sbstjn/68Keys.io/README.md

# 68Keys.io

Build your own 68% mechanical keyboard with the DIY guide on [https://68keys.io](https://68keys.io)!

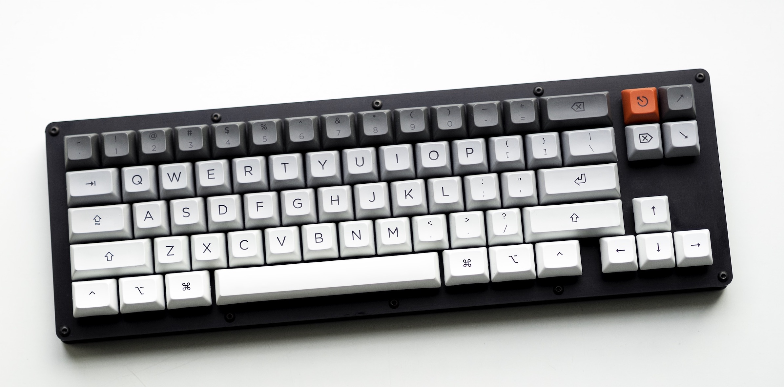
[picture p1: keyboard.jpg]
68Keys.io


> Photo by [Julia Kestner](http://julia-kestner.de/), [BY-NC-SA Creative Commons](https://github.com/sbstjn/68Keys.io/blob/master/LICENSE.md).
