sbstjn/68Keys.io/content/legal.md

---

title: Legal Information
description: Build your own 68% Mechanical Keyboard! Find all information about the Circuit Board, Aluminium Case, and QMK Firmware. A complete shopping list helps you with ordering all parts, and a detailed guide with photos supports you in building your own keyboard!
image: /images/og/splash.jpg

robots: NOINDEX, FOLLOW

---

### Publisher

*German legal information following section 5 TMG and person responsible for the content by 55 Abs. 2 RStV:*

Sebastian Müller\
Stresemannstraße 132\
22769 Hamburg\
Germany

### Contact

Mail: [bonjour@68keys.io](mailto:bonjour@68keys.io)\
Phone: [+49 151 54649055](tel:+4915154649055)

### Data Privacy

This is a static website hosted on [Netlify](https://www.netlify.com/), there is no collection of personal data.

Basic website analytics are done with [heft.io](https://heft.io).

### License

Everything is published using [BY-NC-SA Creative Commons][1], and source are available on [GitHub][7]. All Photos are contributed by [Julia Kestner][2] and shared with the same license.

Icons are from [Nucleo][8] and used with the [Nucleo Standard License][9].

For other external resources, the applying licenses are mentioned inline.

### Donations

If you enjoy this and want to show your love, [Dogecoins](http://dogecoin.com/) are much appreciated:

<code class="wallet">D8mKpbfGxHgadKdgoewkmXETN4JCgj92Xw</code>

### Disclaimer

The content of [68Keys.io][3] has been created with the utmost care. However, I cannot guarantee the contents' accuracy, completeness or topicality. According to statutory provisions, I am furthermore responsible for my content on these web pages. In this context, please note that I am accordingly not obliged to monitor merely the transmitted or saved information of third parties, or investigate circumstances pointing to illegal activity. My obligations to remove or block the use of information under generally applicable laws remain unaffected by this as per §§ 8 to 10 of the Telemedia Act (TMG).

Responsibility for the content of external links (to web pages of third parties) lies solely with the operators of the linked pages. No violations were evident to me at the time of linking. Should any legal infringement become known to me, I will remove the respective link immediately.

[1]: https://github.com/sbstjn/68Keys.io/blob/master/LICENSE.md
[2]: http://julia-kestner.de
[3]: https://68Keys.io
[7]: https://github.com/sbstjn/68keys.io
[8]: https://nucleoapp.com
[9]: https://nucleoapp.com/license
