sbstjn/68Keys.io/static/images/board/arduino-board.jpg

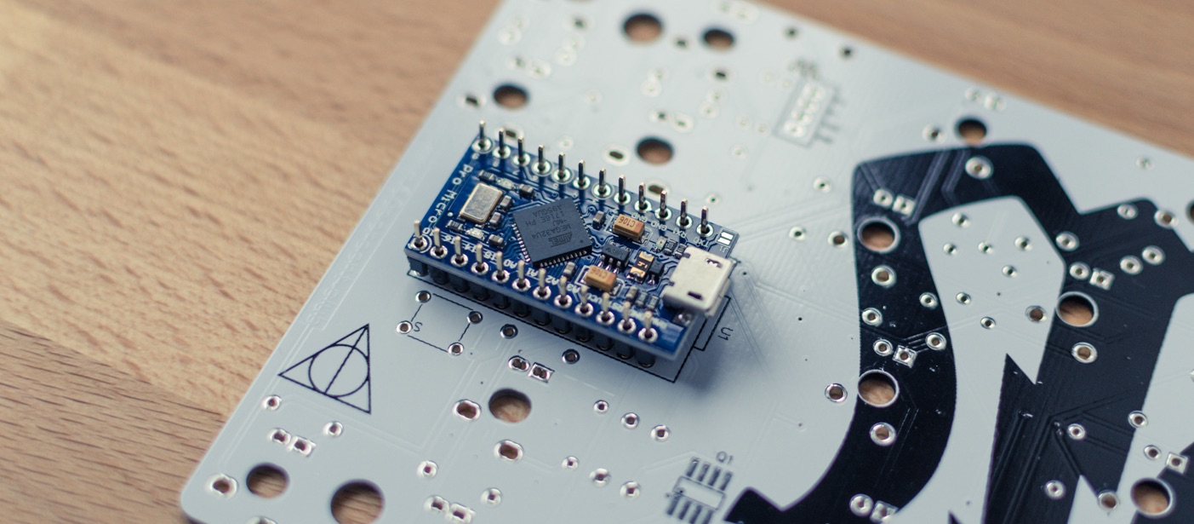
static/images/board/arduino-board.jpg
