sbstjn/68Keys.io/static/images/board/diodes-pre.jpg

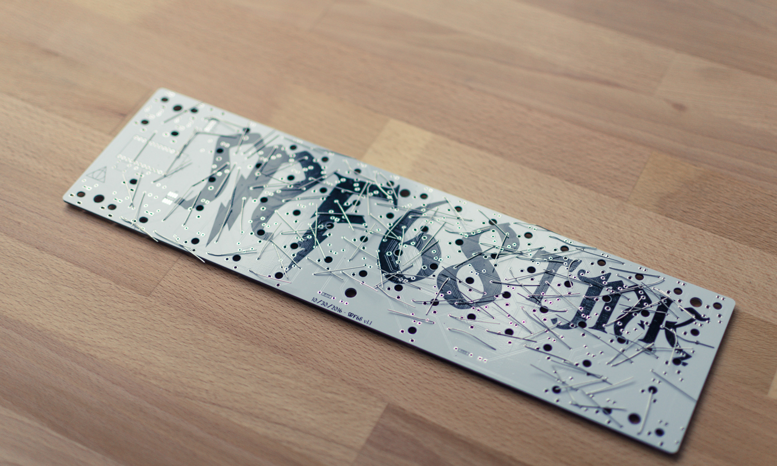
static/images/board/diodes-pre.jpg
