sbstjn/68Keys.io/static/images/board/diodes.jpg

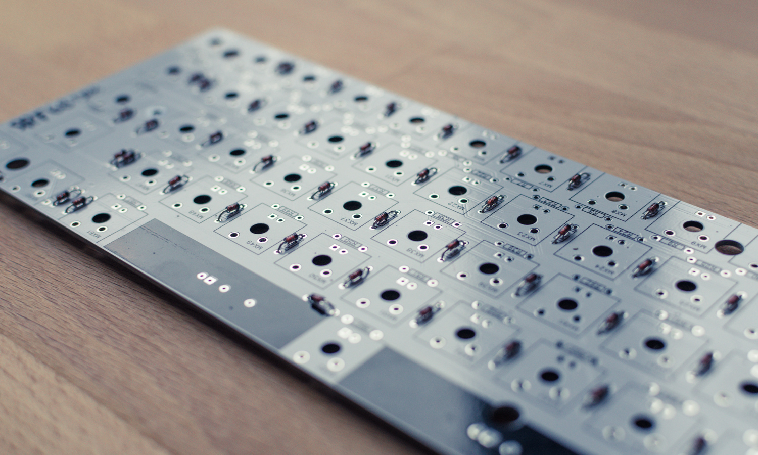
static/images/board/diodes.jpg
