sbstjn/68Keys.io/static/images/board/screenshot-easyeda.png

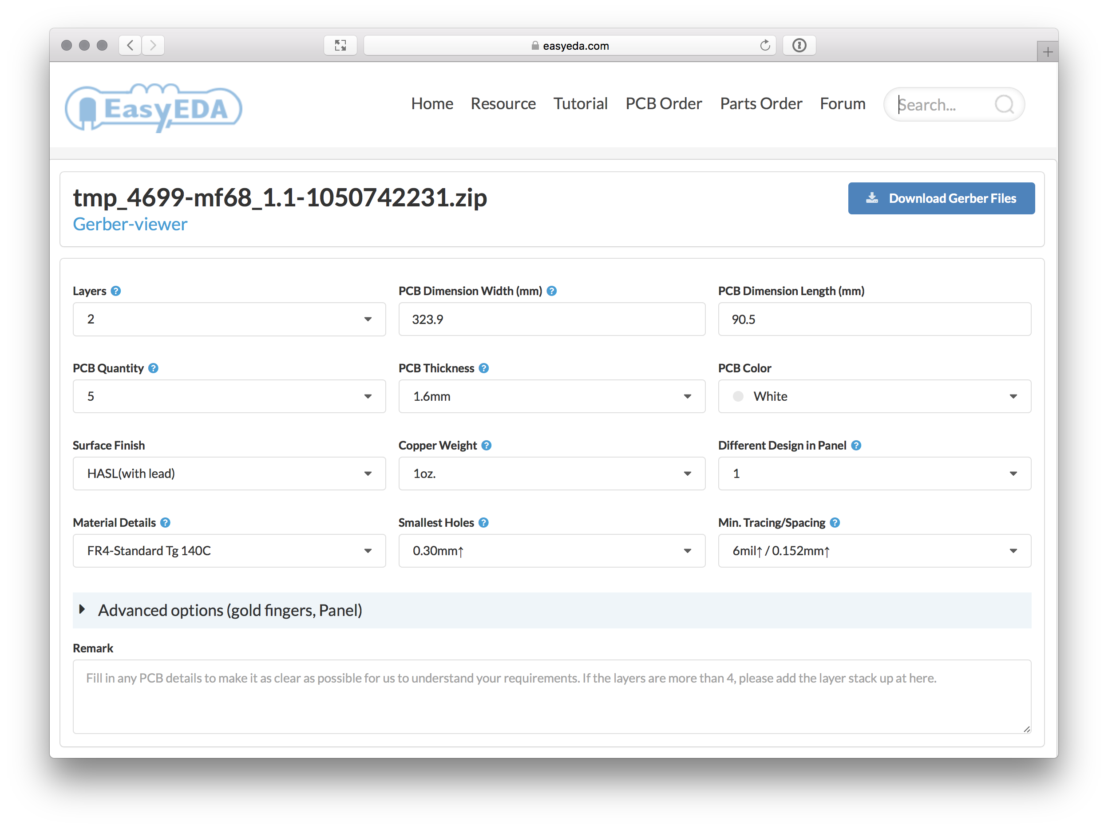
static/images/board/screenshot-easyeda.png
