sbstjn/68Keys.io/static/images/board/screenshot-preview.png

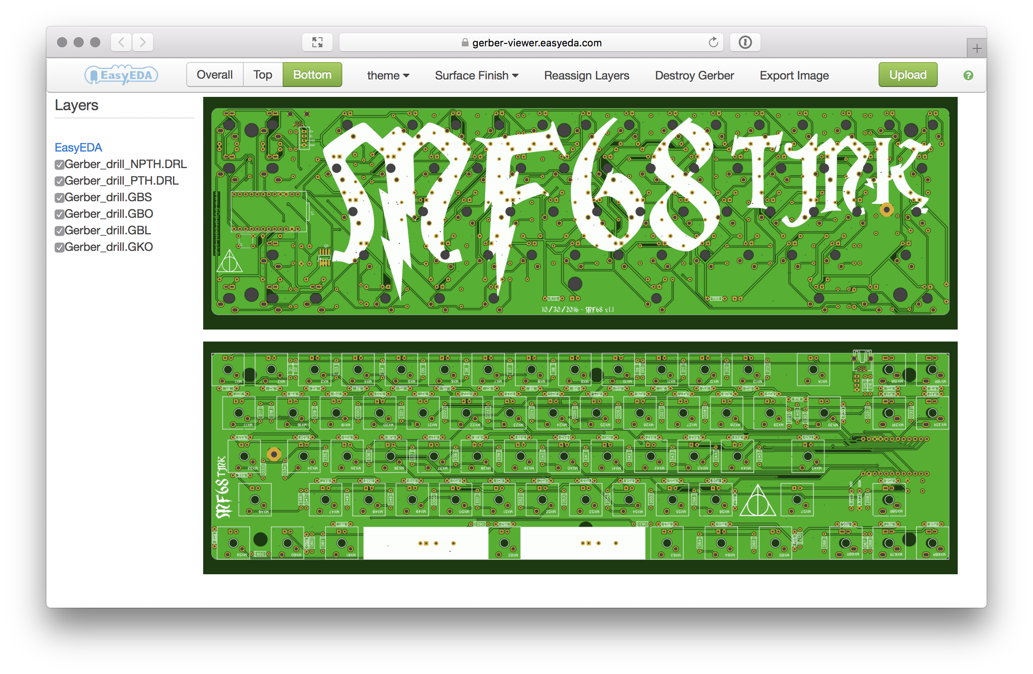
static/images/board/screenshot-preview.png
