sbstjn/68Keys.io/static/images/case/clean-both.jpg

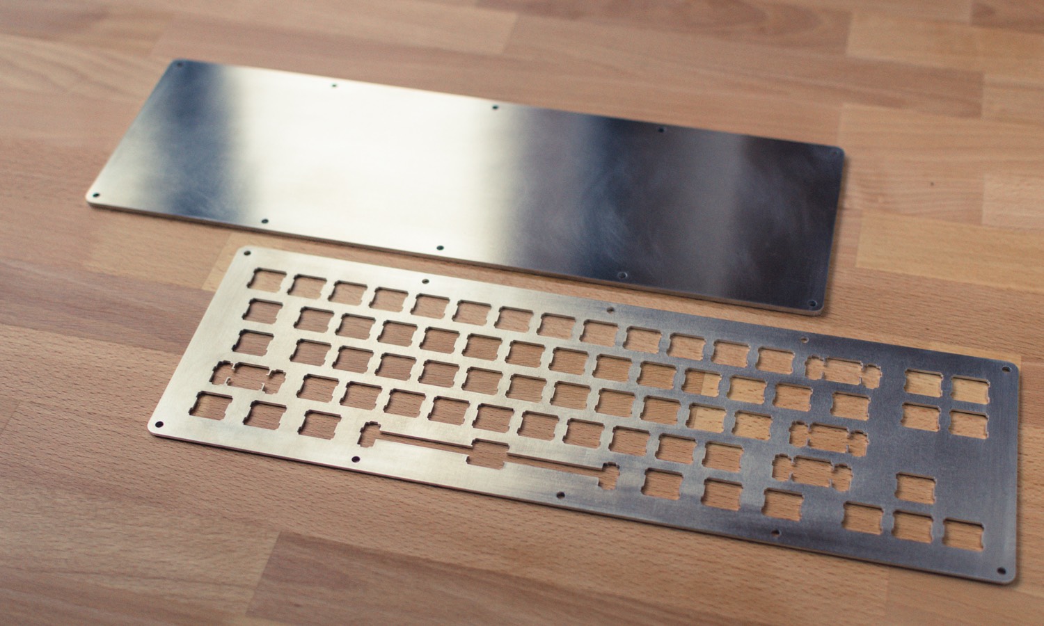
static/images/case/clean-both.jpg
