sbstjn/68Keys.io/static/images/case/clean-top.jpg

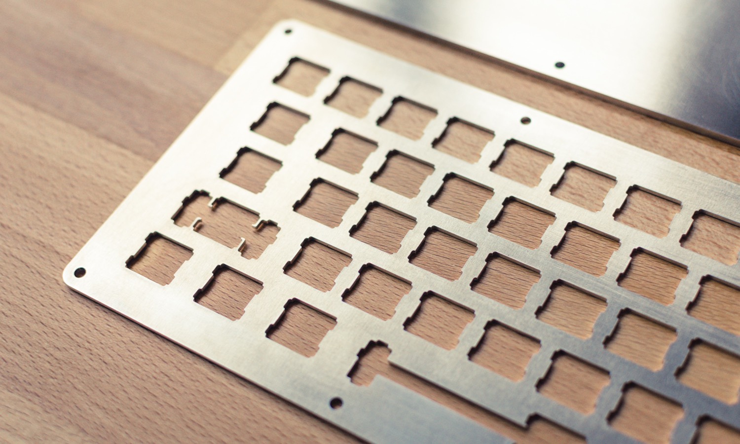
static/images/case/clean-top.jpg
