sbstjn/68Keys.io/static/images/case/plates-black.jpg

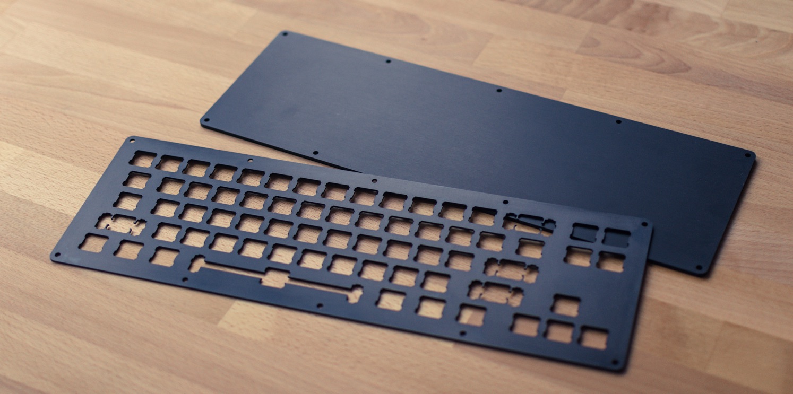
static/images/case/plates-black.jpg
