sbstjn/68Keys.io/static/images/case/raw-both.jpg

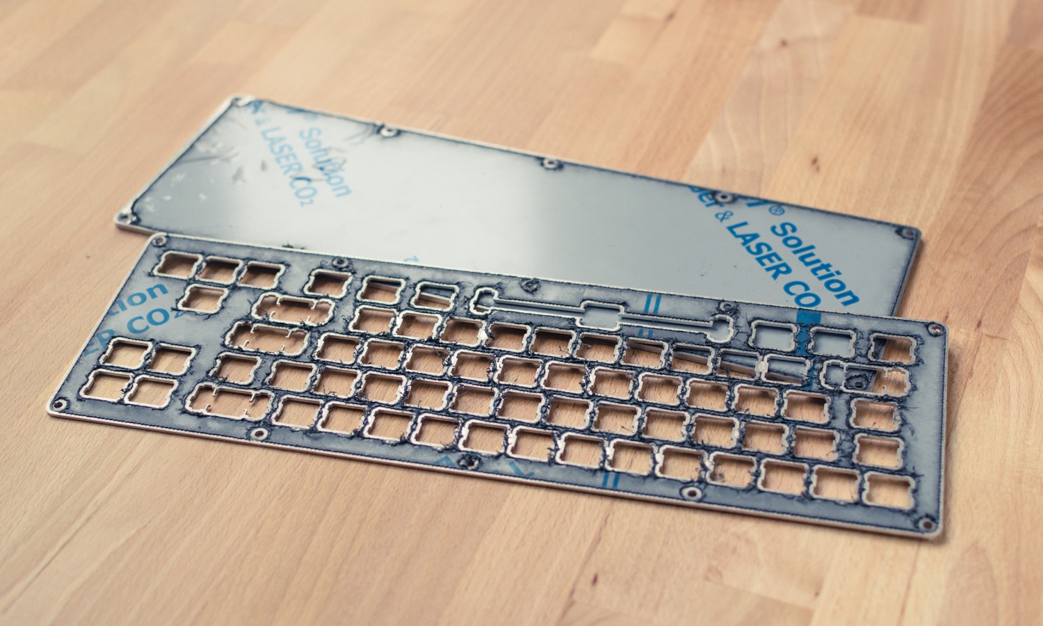
static/images/case/raw-both.jpg
