sbstjn/68Keys.io/static/images/case/raw-top.jpg

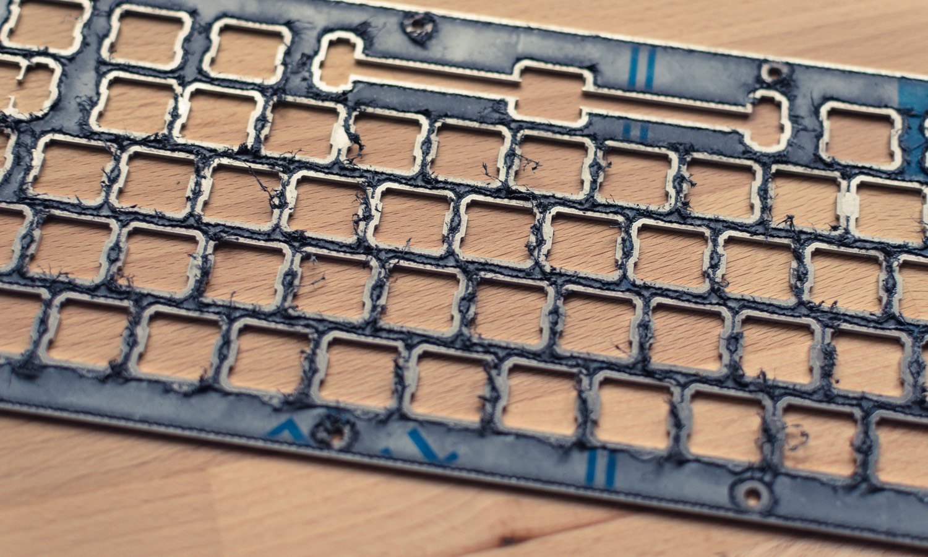
static/images/case/raw-top.jpg
