sbstjn/68Keys.io/static/images/case/screenshot-kle.png

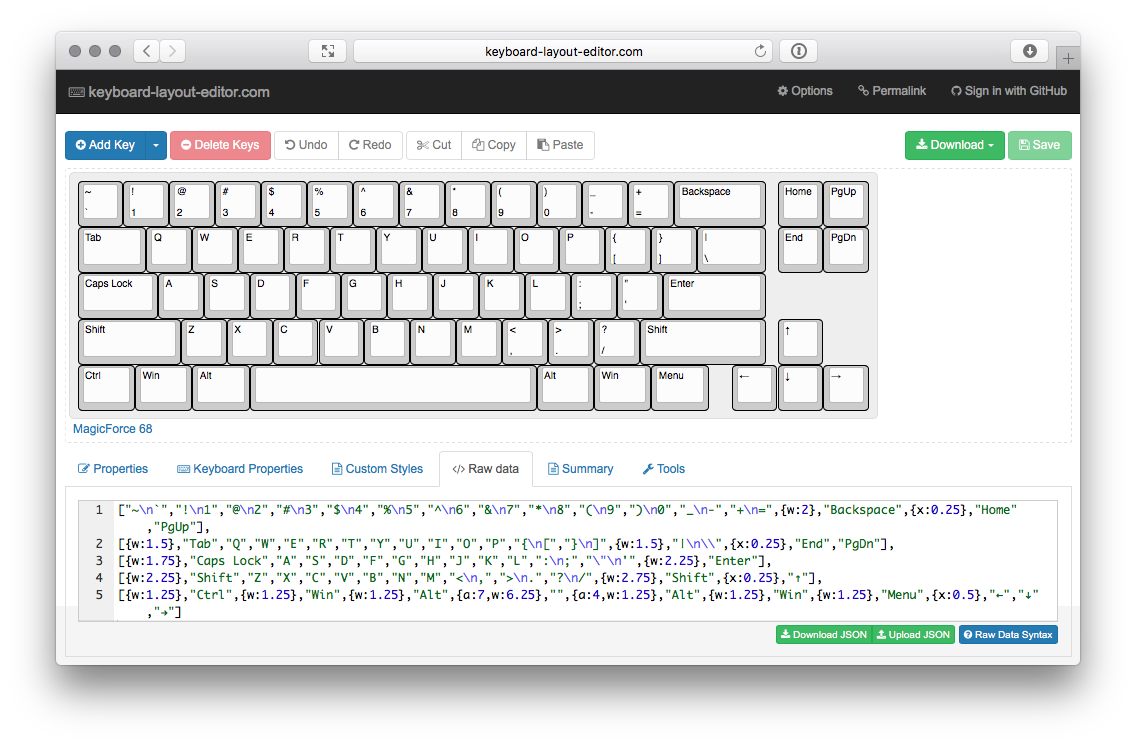
static/images/case/screenshot-kle.png
