sbstjn/68Keys.io/static/images/header.jpg

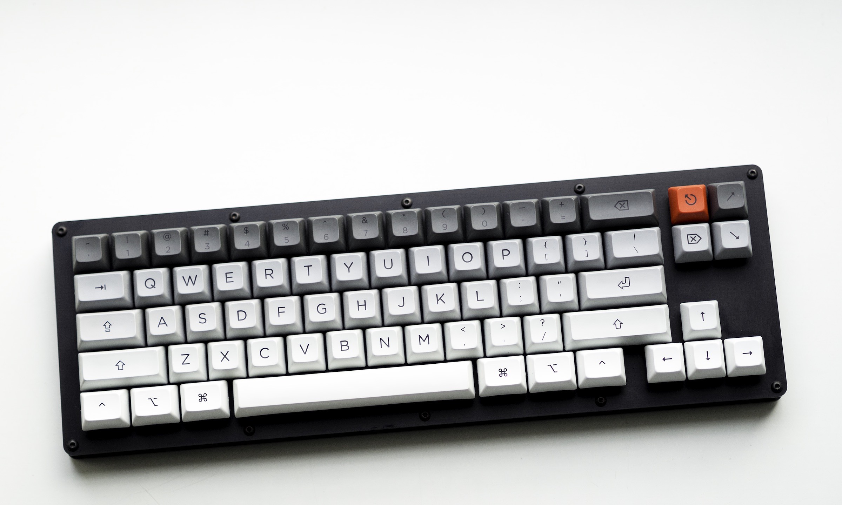
static/images/header.jpg
