sbstjn/68Keys.io/static/images/intro.jpg

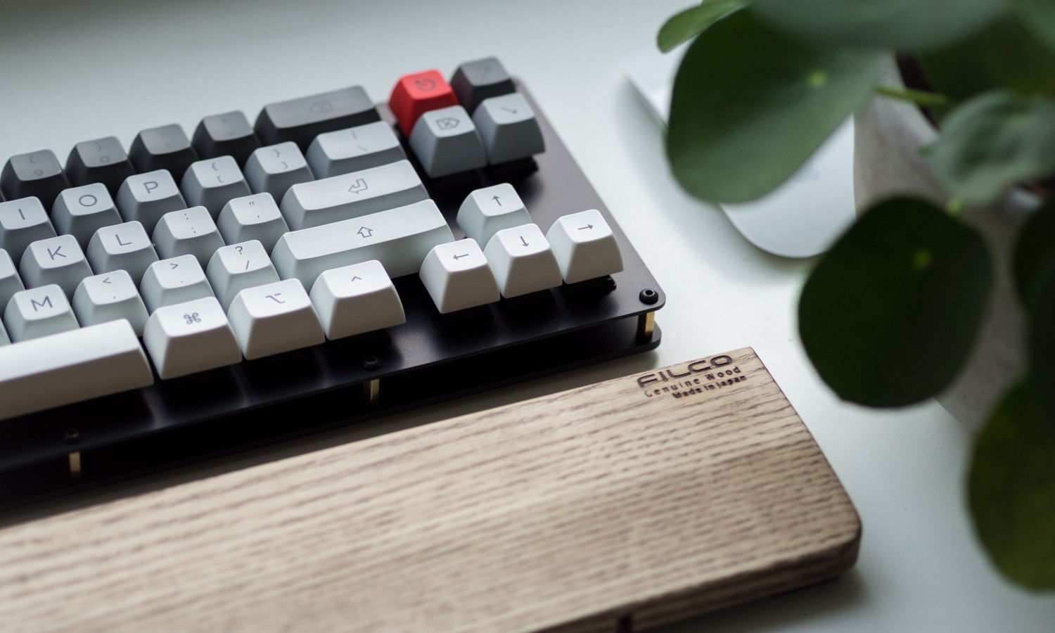
static/images/intro.jpg
