sbstjn/68Keys.io/static/images/board/parts.jpg

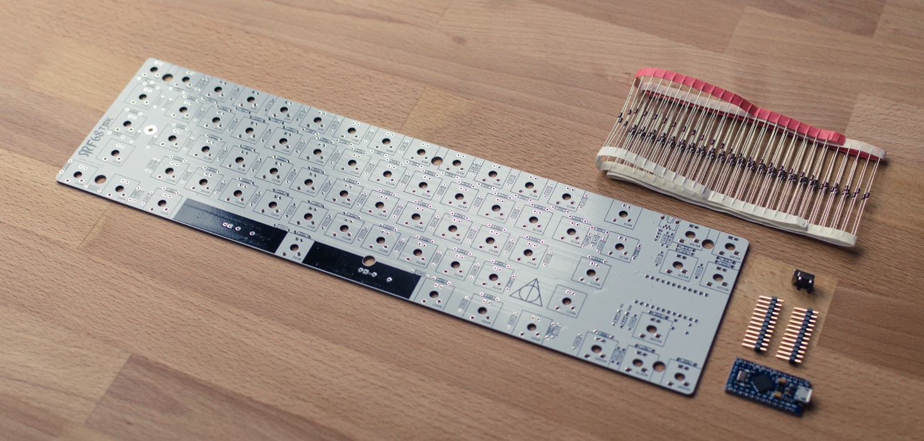
static/images/board/parts.jpg
