sbstjn/68Keys.io/static/images/case/parts-black-assembled.jpg

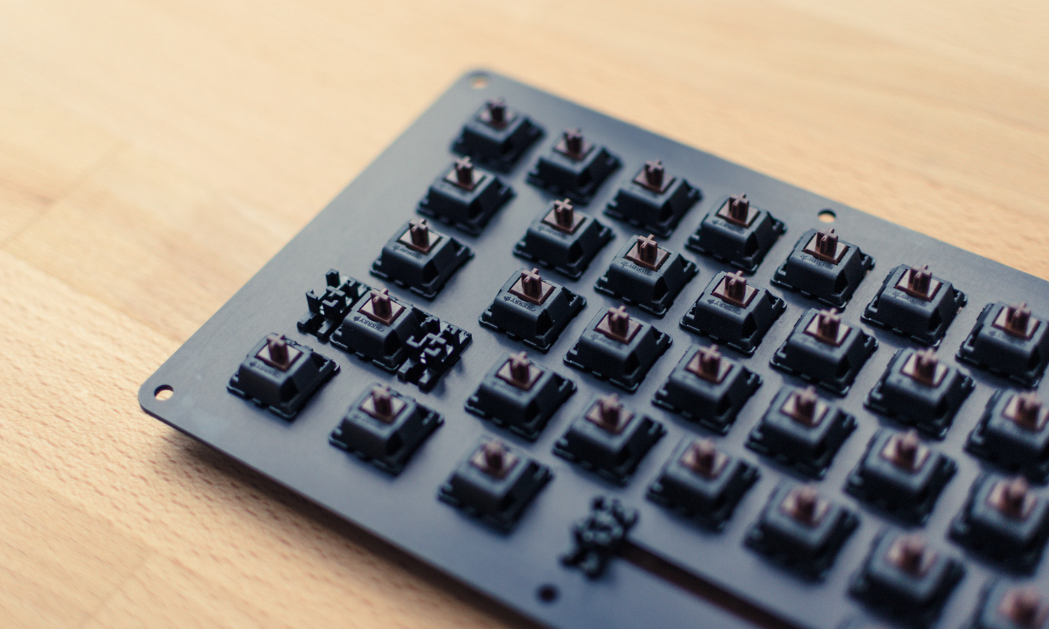
static/images/case/parts-black-assembled.jpg
