sbstjn/68Keys.io/static/images/case/parts-black.jpg

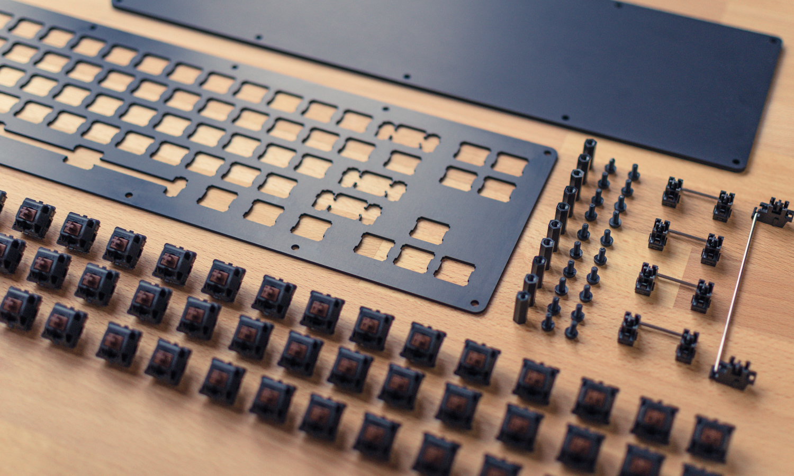
static/images/case/parts-black.jpg
