sbstjn/68Keys.io/static/files/case/cover.dxf

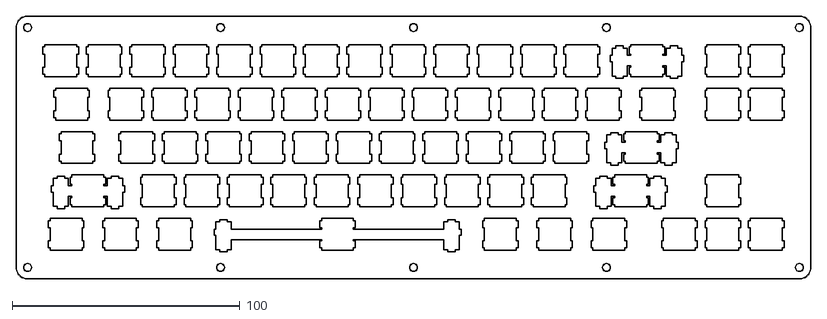
[picture p18: CAD file, 2018-01-27]
static/files/case/cover.dxf
348.6 x 115.3
