sbstjn/68Keys.io/static/files/case/bottom.dxf

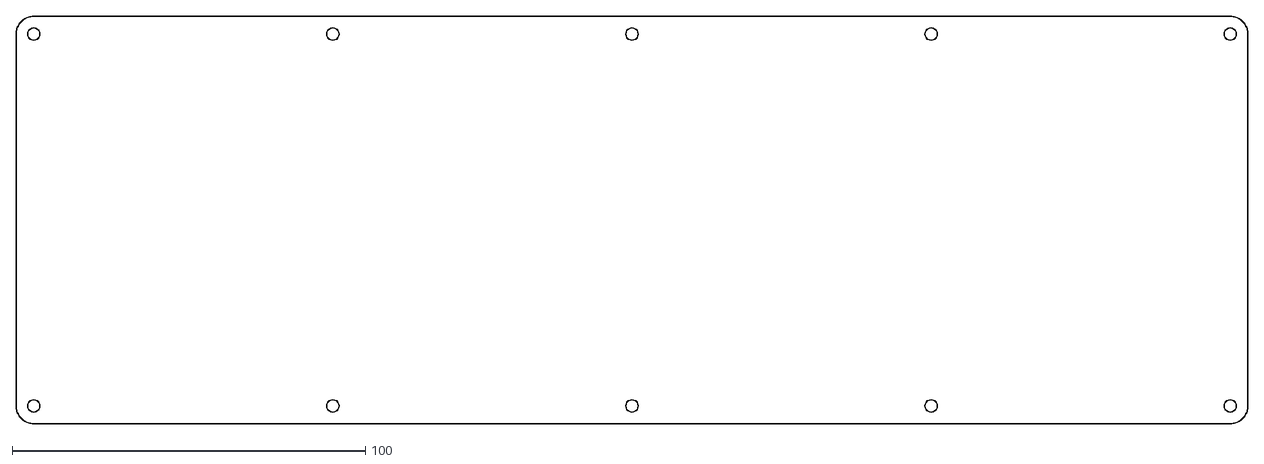
[picture p19: CAD file, 2018-01-27]
static/files/case/bottom.dxf
348.6 x 115.3
