sbstjn/68Keys.io/static/images/board/diodes-assembled.jpg

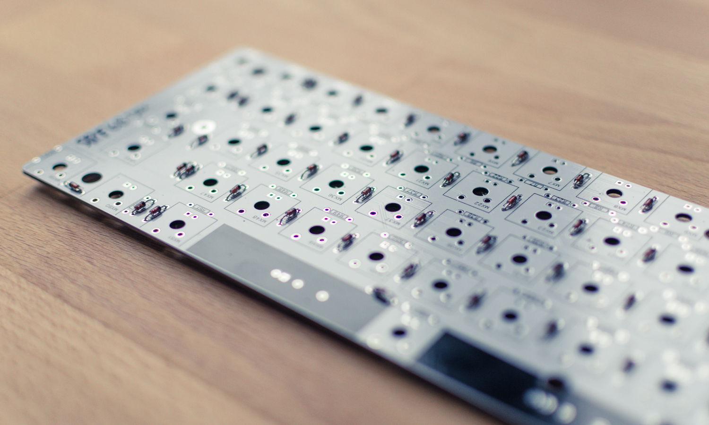
static/images/board/diodes-assembled.jpg
