sbstjn/68Keys.io/static/images/case/black-assembled.jpg

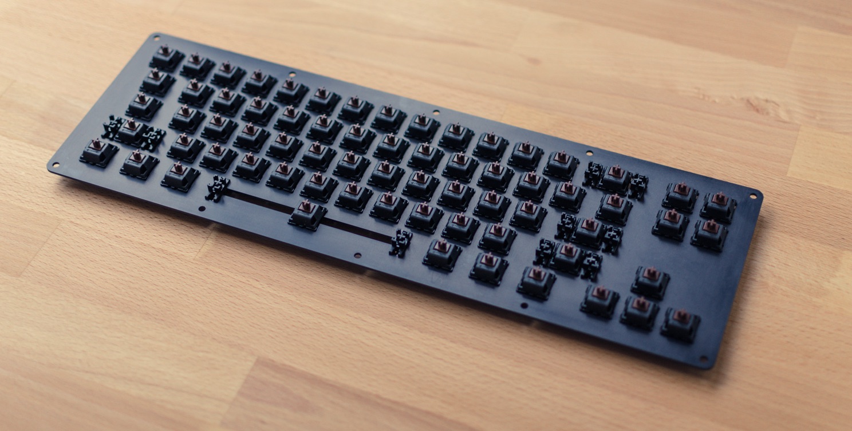
static/images/case/black-assembled.jpg
