sbstjn/68Keys.io/static/images/case/screenshot-builder.png

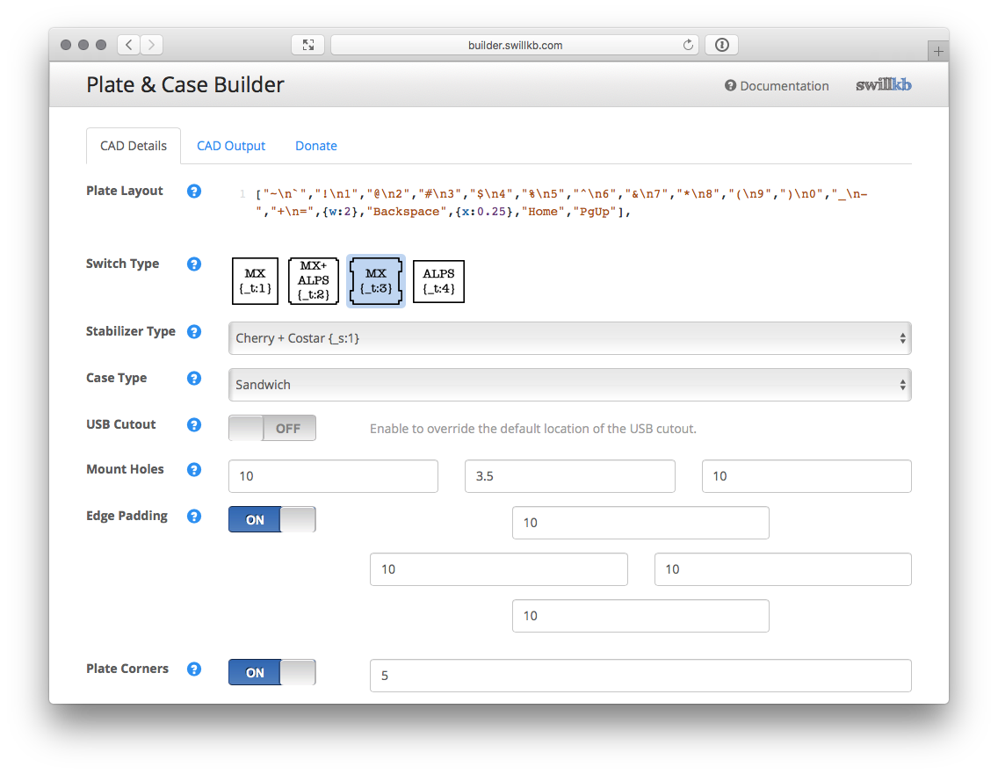
static/images/case/screenshot-builder.png
